sidv1711/stryd-smartwatch/smartwatch/secrets.example.h

#pragma once

// Template — copy to secrets.h and fill in.
// secrets.h is gitignored so your real credentials stay local.

#define WIFI_SSID      "YOUR_SSID"
#define WIFI_PASS      "YOUR_PASSWORD"

// Latitude / longitude used for the Open-Meteo current-weather query.
// Default = San Francisco; replace with your coords.
#define WEATHER_LAT    37.7749f
#define WEATHER_LON   -122.4194f
