sidv1711/stryd-smartwatch/(commit log)

2026-05-04 steps, imu fix
2026-06-01 Wire on-device HAR: TFLM classifier, 50Hz IMU ring buffer, Activity screen
2026-06-01 Fix ML pipeline: drop TF<2.20 pin, handle UCI nested-zip layout
