sidv1711/stryd-smartwatch/images/pcb-after-reflow.jpeg

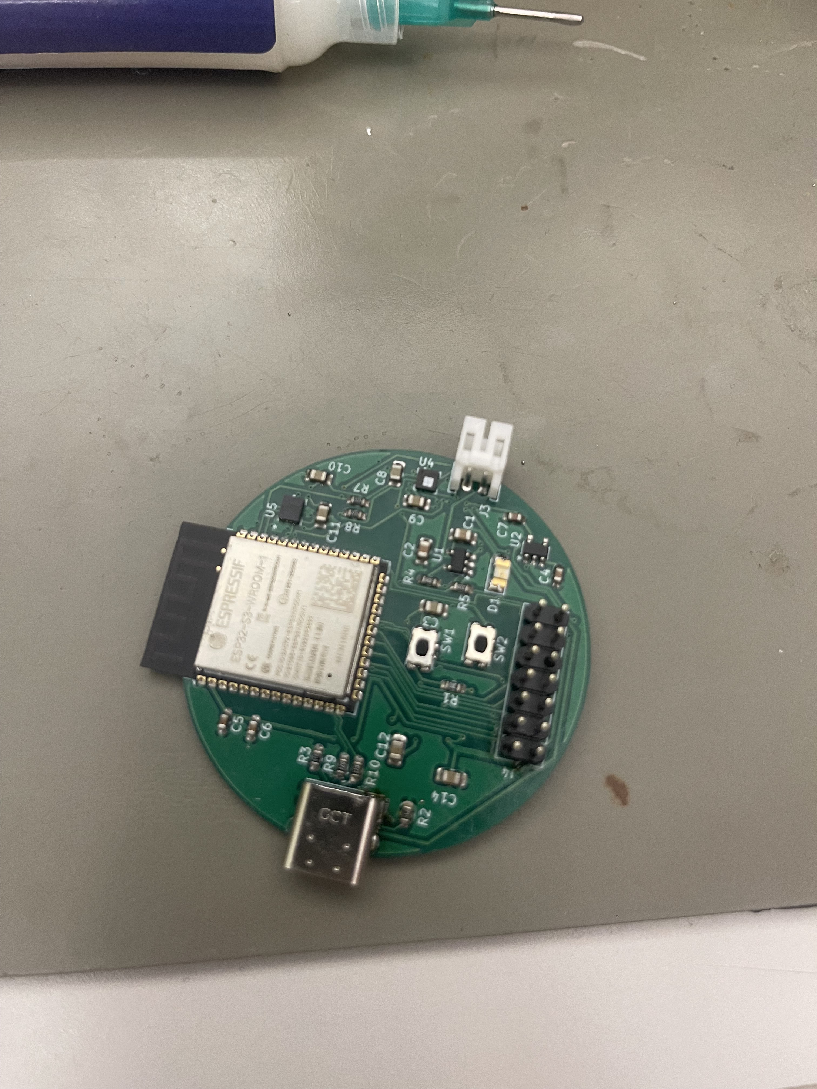
[picture p6: images/pcb-after-reflow.jpeg]
images/pcb-after-reflow.jpeg
