sidv1711/stryd-smartwatch/images/bringup-debug-laptop.jpeg

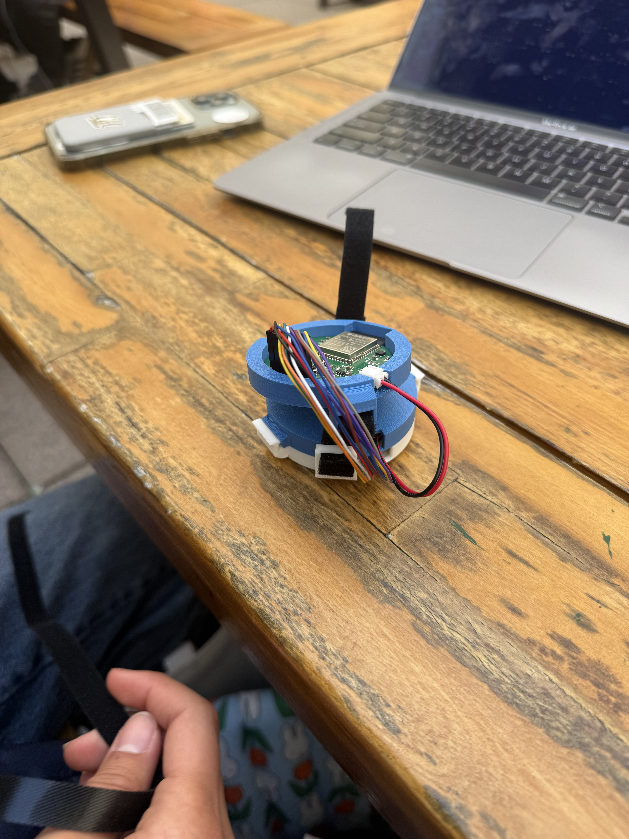
[picture p12: images/bringup-debug-laptop.jpeg]
images/bringup-debug-laptop.jpeg
